harshul319/FSEV/ReadMe

These are the documents on the FSEV of IIT-KANPUR that I worked upon as the head of the powertrain subsystem and also the cad design (still under iterations) of a planetary gearbox thst we are gonna use in our next FSEV
