harshul319/FSEV/E13_IITKMotorsports_CRMR_2025_V1.pdf

Formula Bharat 2025 | Concept Resources Management Report (CRMR)
E 13 | IITK Motorsports | Indian Institute of Technology Kanpur

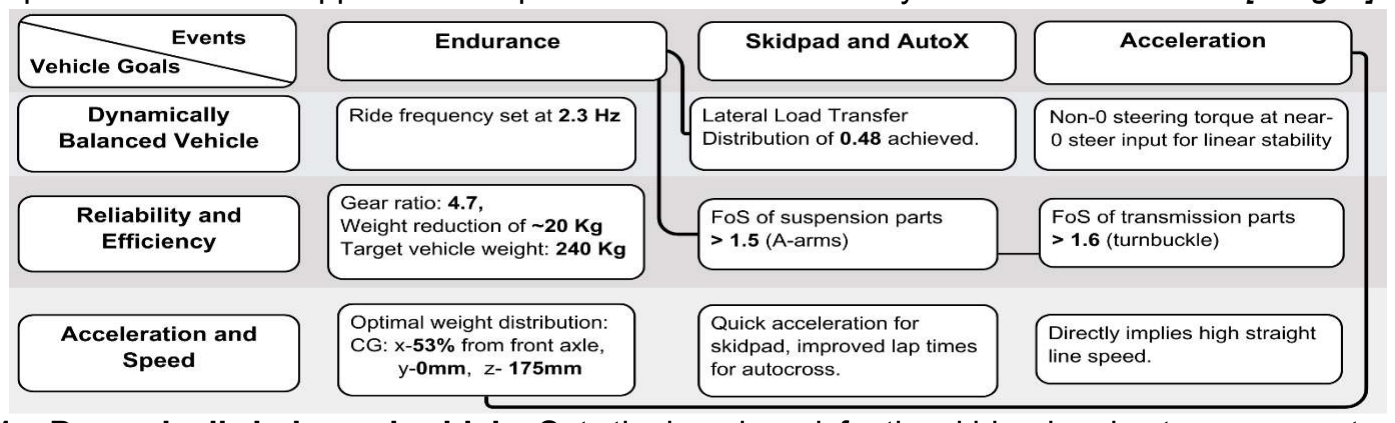
[picture p1: figure]
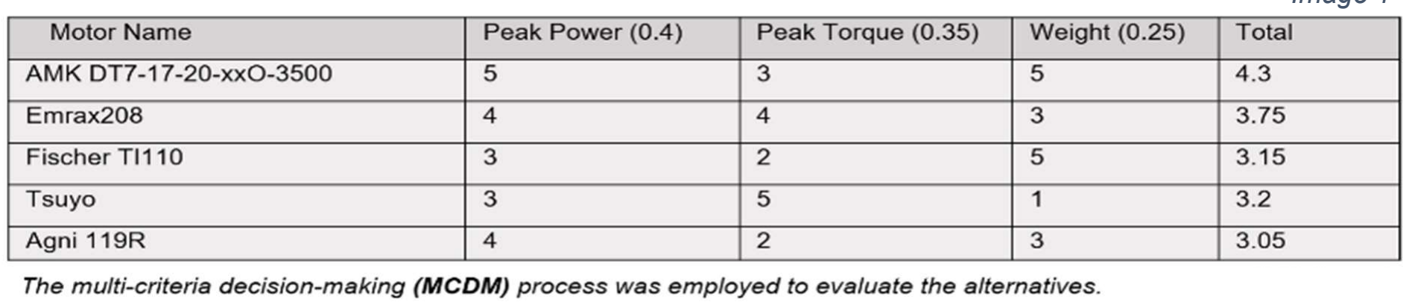
[picture p2: figure]

1 | 10

Formula Bharat 2025: Concept Resources Management Report

Through the CRM report, IITK Motorsports presents its unconstrained design ideology, efficient resource utilisation, and strategic project management for its second FSEV.
200+ minutes and 120+ km of testing of the team’s first FSEV, participation in FB24 and FB23 Class 1, and feedback from the judges have strengthened our engineering foundation. Our vision is to build the world's best FSEV while strategically navigating the constraints.
The section below outlines our vehicle goals and their importance in excelling as a team and at the dynamic events in a Formula Student competition.

Vehicle goals: The image below highlights the vehicle goals and the derived vehicle
specifications that support vehicle performance in different dynamic events. | [Image1]
1. Dynamically balanced vehicle: Sets the benchmark for the skidpad and autocross events.
- The best skidpad time in Formula Student is 4.43 seconds, achieved by the unconstrained parameters, our team achieved a simulated skidpad time of 4.60 seconds on OptimumLap software.
- The LLTD (image 2) of 0.48 was achieved for better cornering, with the ride frequency set to 2.3 Hz, matching a person's natural walking frequency.

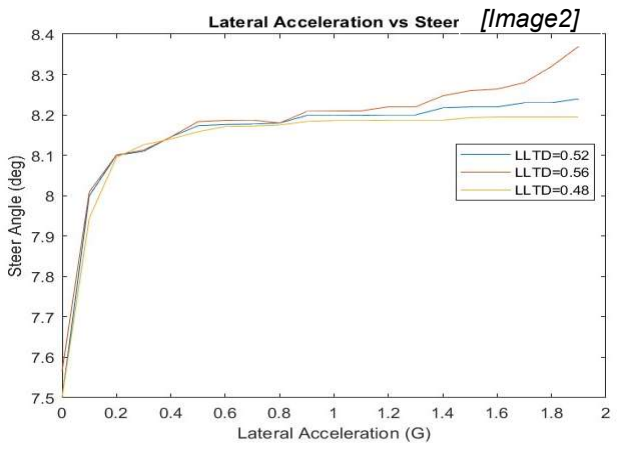
[picture p3: figure]
[Image2]

2. Acceleration and speed: This goal directly impacts the acceleration event.
- The best time for acceleration in Formula Student is 3.27 seconds. The team targeted a peak longitudinal acceleration of 8 m/s²
to achieve competitive times.
- Comparing various motors, disregarding constraints like cost, inverter availability, and experience, showed that the AMK DT7 meets our requirements best.
Image 1
- Simulated Acceleration time = 4.46 s; Peak longitudinal acceleration = 7.56 m/s² .

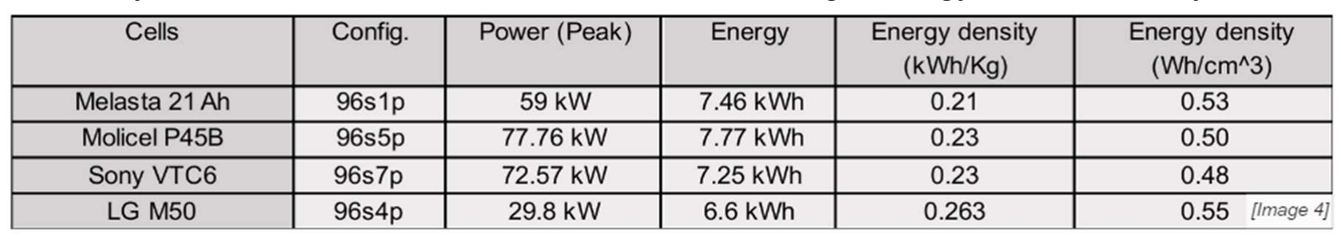
[picture p4: figure]
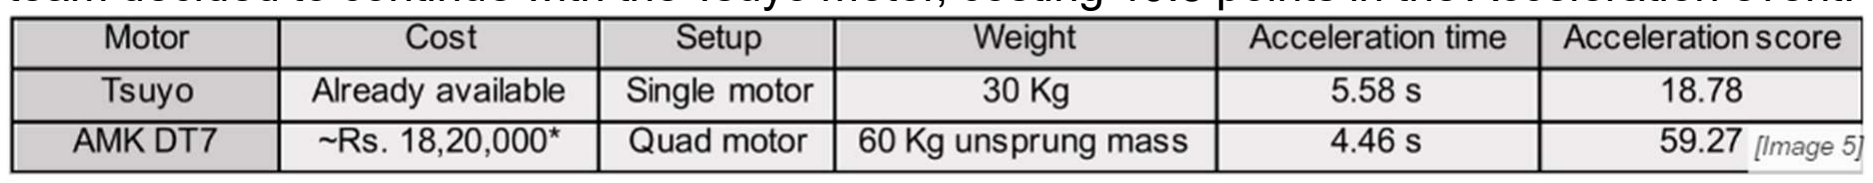
[picture p5: figure]
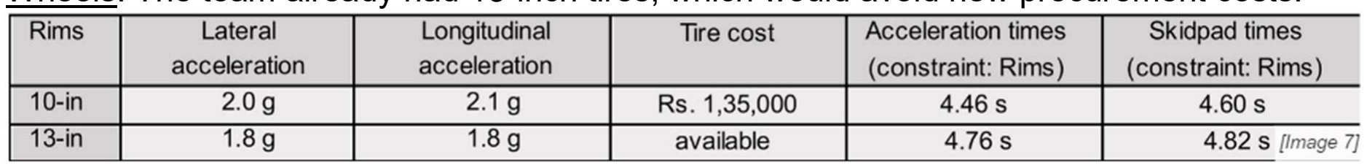
[picture p6: figure]
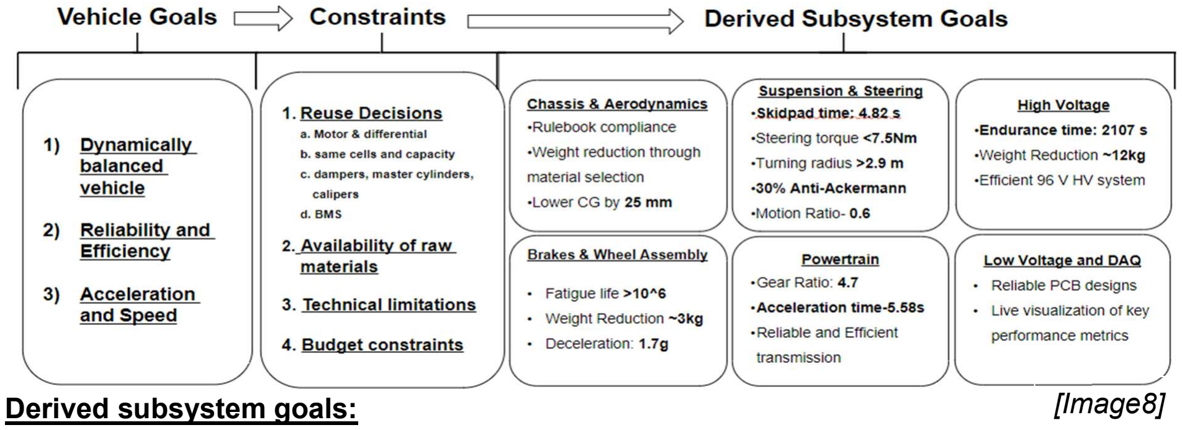
[picture p7: figure]
Derived subsystem goals:; [Image8]

2 | 10
3. Reliability and Efficiency: Aligns with the Endurance and Efficiency event objectives.
- Upon analysing endurance times, a target was set to complete the event in < 23.3 min.
- Recognising the high loads on suspension parts during skidpad and stress on transmission parts during acceleration, a FoS > 1.5 was set for critical components. After evaluating various options, Melasta cells were chosen since pouch cells simplify assembly, have UV-weldable tabs with busbars, and high energy volume density.

96S was chosen for easier segmentation and to meet the required energy storage and power output. Lap-time simulation results and parameters for unconstrained vehicle:
- Endurance Time: 1369 s - Required energy: 7.28 kWh, Battery capacity: 7.77 kWh
- Battery: Melasta 21Ah - Battery configuration: 96s1p
Constraints: The team views its constraints as an opportunity to turn limitations into strengths. Points or time losses were also assessed due to each constraint independently.
- Motor & Differential: Constrained by budget, but considering reliability and familiarity, the team decided to continue with the Tsuyo motor, costing 40.5 points in the Acceleration event.
- DNM Dampers, Brake Calipers & Master Cylinders were reused due to familiarity, although performance comparisons for alternatives were made.
- Wheels: The team already had 13-inch tires, which would avoid new procurement costs.
- Lack of availability of crucial raw materials such as Al 7075 blocks, AISI4130 tubes, high-end electrical components, UL-94-rated polycarbonate sheets, etc. around the college.
- Monocoque chassis could reduce the chassis weight from 32 kg to 23 kg but the shift is hindered due to lack of manufacturing resources, technical ineptitude, and budget issues.
A. Suspension and Steering: Setting parameters to achieve the simulated skidpad times.

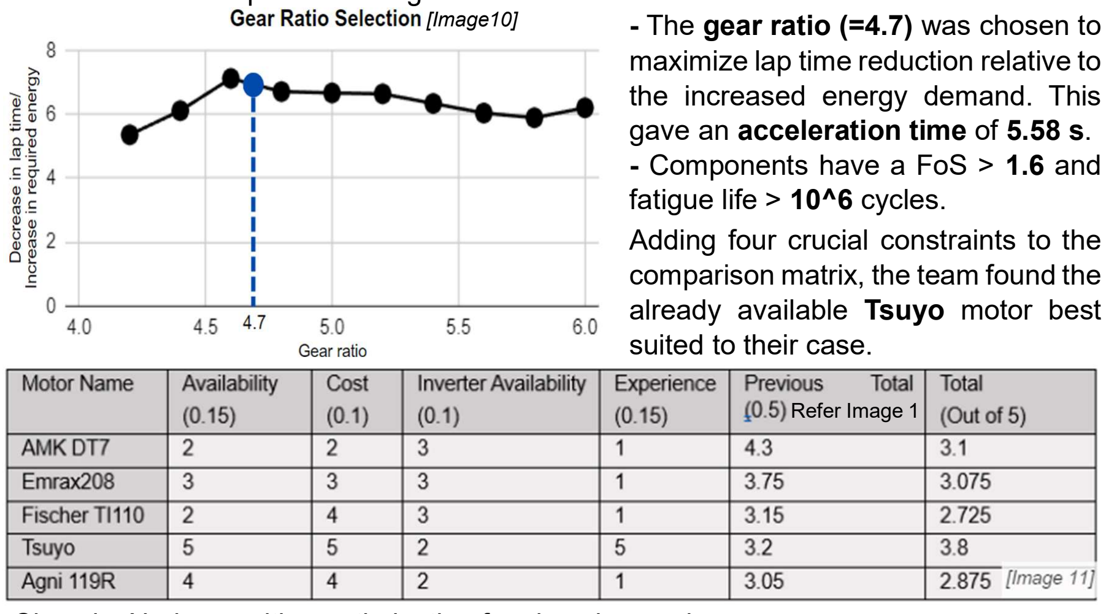
[picture p8: figure]
- The gear ratio (=4.7) was chosen to maximize lap time reduction relative to the increased energy demand. This gave an acceleration time of 5.58 s. - Components have a FoS > 1.6 and fatigue life > 10^6 cycles. Adding four crucial constraints to the comparison matrix, the team found the already available Tsuyo motor best suited to their case.; [Image10]; Refer Image 1
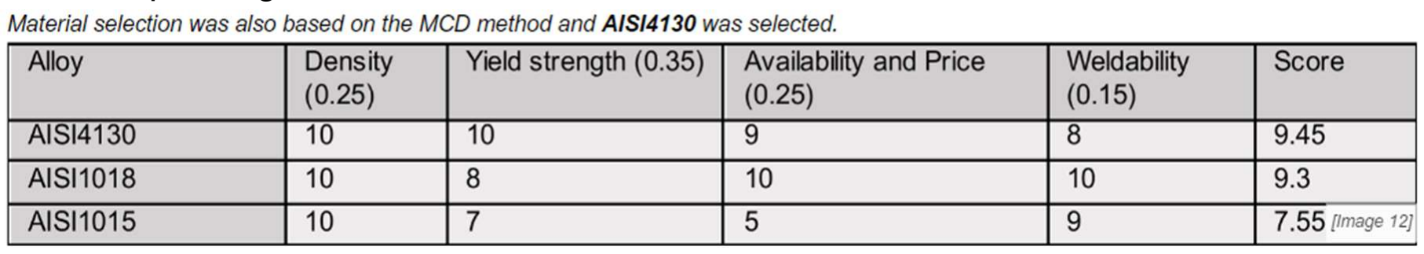
[picture p9: figure]

3 | 10

Retrospective Insights: Excess steering effort, higher CG, uneven tire wear due to camber loss while the minimum turning radius set and achieved on track was 3.7m and 4.5m.
- Utilizing TTC data to precisely calculate the steering torque and limit it to 7.5 Nm.
- Calculating optimal slip angles and setting a 30% anti-Ackermann geometry.
- Minimum turning radius is dynamically calculated and set to 2.9 m.
- The final LLTD value achieved was 0.44
- The caster angle is set to 3° to restrict camber loss and uneven tire wear.
The | team | effectively | managed the
constraint of using 13-inch rims, which

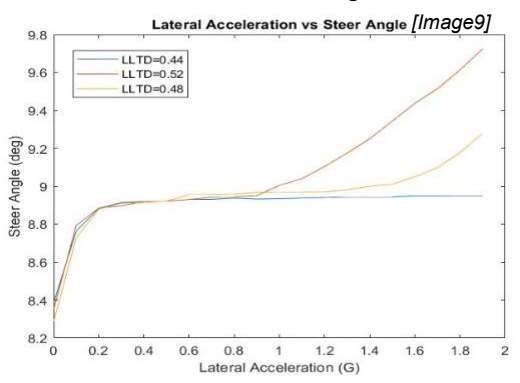
[picture p10: figure]
[Image9]

resulted in a minimal increase in skidpad time, from 4.60 seconds to 4.82 seconds.
B. Powertrain: Optimize gear ratio for endurance with balanced acceleration performance.
- Transmission components designed to withstand extreme loads.
C. Chassis: Nodes-position optimization for chassis members.
- Achieving higher torsional stiffness (3708 N/rad) and lowering CG height (by 25 mm)
- The spaceframe node positions are derived from a MATLAB model, selecting nodes corresponding to minimum deflection under identical load conditions.
D. Brakes and Wheel Assembly: Reduced weight and increased strength of components. Retrospective insights: Inaccurate dynamic load analysis led to the front hub failure.
- Weight target of knuckle, spindle and hub assembly = 2 kg.
- Using TTC data helped achieve a higher peak deceleration of 1.7g.
- Integrated hub and spindle design with FoS >1.5 and fatigue life >10⁶ cycles.
E. Aerodynamics: Increasing downforce for higher cornering speed and better handling.
- Limiting drag for better efficiency and greater speed on a straight track.

4 | 10
- Optimized Cl and Cd values to achieve a ratio of 2.5 (Cl: -2, Cd: 0.8).
- A downforce of 695 N was generated for an average vehicle velocity of 20 m/s.
F. High Voltage: Efficient thermal management and reduction in weight by 12 kg.
- BMS-controlled cooling ensures optimum fan speed for efficient cooling.
- The vehicle's endurance time was 2107 s (~35 min), requiring 3.59 kWh of energy.
- 24s2p configuration gives an 88.8 V nominal pack voltage, which lies in the controller range of 85-96 V, and 3.7 kWh capacity, and meets the energy requirements.
- Due to the success of last year's Orion BMS 2, we reused the same BMS.
G. Low voltage and Data Acquisition: Reliable PCB designs.
- SMD components on PCBs for noise reduction and optimal signal transmission.
- Over-current and reverse polarity protection and thermal rating for all custom PCBs.
- Open-circuit and short-circuit detection for all sensors used for Data Acquisition. Points Projection:
- Based on the lap times vs historical and projected best times, the team is positioned to secure 1st place in Endurance (325 pt), Efficiency (100 pt), and Skidpad (75 pt), 2nd in autocross (73.27 pt) and 3rd in Acceleration (18.78 pt), anticipating cumulative dynamic events score of over 592 pt.
- The team also targets over 290 pt in the static events, reflecting the historical averages of the winners.

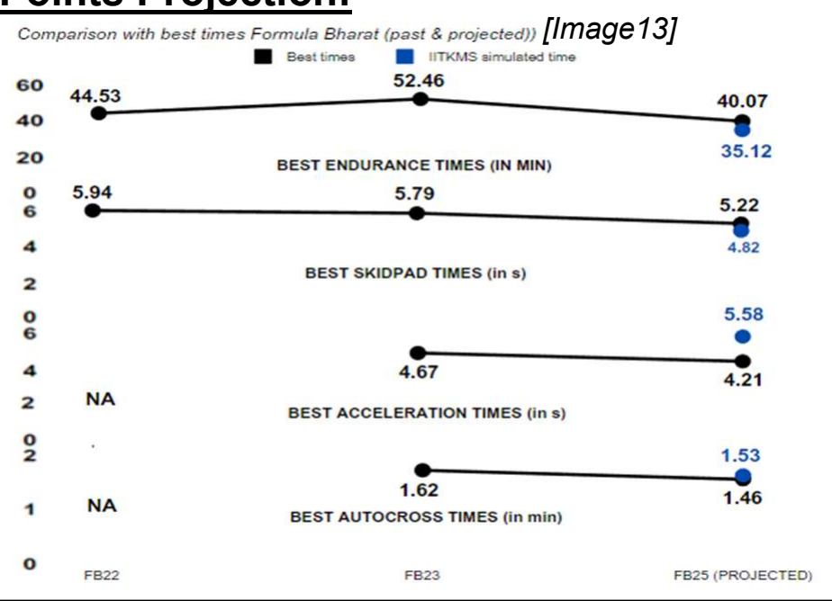
[picture p11: figure]
[Image13]

Our projected score is 882 out of 1000 points, positioning us to dominate the competition. Improvement areas:
The team seeks feedback to identify improvement areas and values external insights while prioritizing introspection. Committed to excellence, we refine strategies and turn limitations into innovative solutions, driving our pursuit of being the best. Key focus areas include:
1. 10-inch rims balance weight reduction with better handling for acceleration and cornering.
2. Lightweight, compact motors and AWD or 4WD systems for improved traction.
3. Regenerative braking converts braking energy into usable power, enhancing efficiency.
4. Anti-roll bar linkage reduces vehicle roll during cornering, allowing for softer spring rates.
5. Liquid cooling stabilizes accumulator temperature and handles extreme conditions better.
6. Undertaking of the development of BMS by the electrical subsystems.
7. Electronics feature negative feedback and voltage detection for precharge circuits, CAN communication for display, and a Vehicle Control Unit for vehicle monitoring.
Tools:

### 1. Computational and Analytical Tools:

a. Ansys: FEA simulations of components including static analysis and topology optimization of components to obtain deformation, FoS, stress, and strain values.
b. Ansys Fluent: Cooling analysis of battery pack, CFD analysis of airfoils.
c. SolidWorks: Design of individual parts along with assembly of the complete vehicle, also used as a tool to validate FEA values from Ansys
d. Altium: Primary tool for the design and simulation of circuit designs.
e. Orion CAN software: To configure BMS for the motor controller and charger, and assess battery parameters like temperature and SoC.
f. Tsuyo Live software for motor tuning and motor controller configuration.
The team has extensively used modeling and simulation tools like MATLAB, Lotus Shark, and OptimumLap. The Simulations and models are listed in the image.

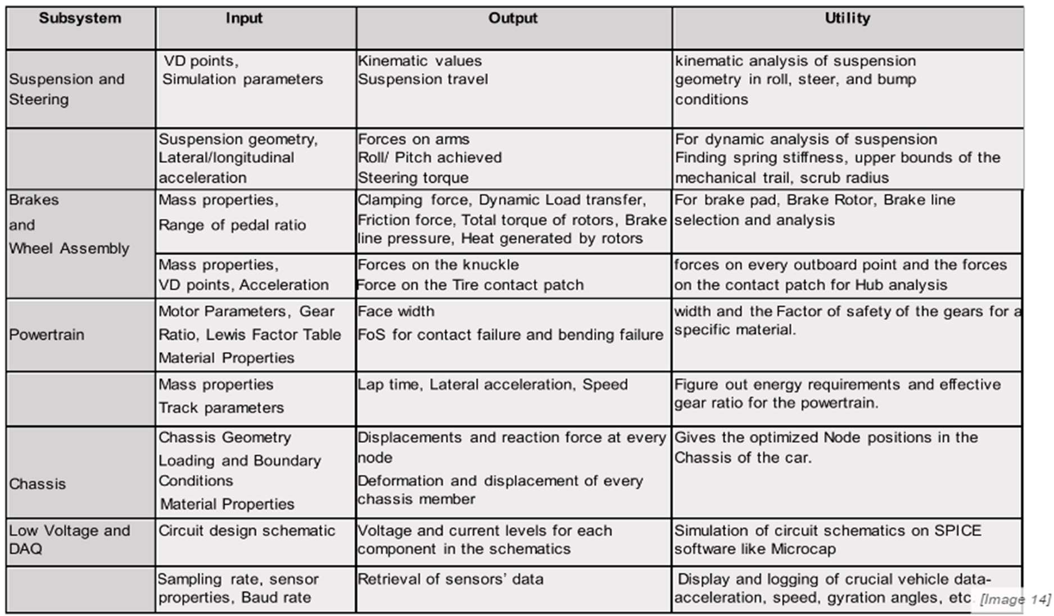
[picture p12: figure]
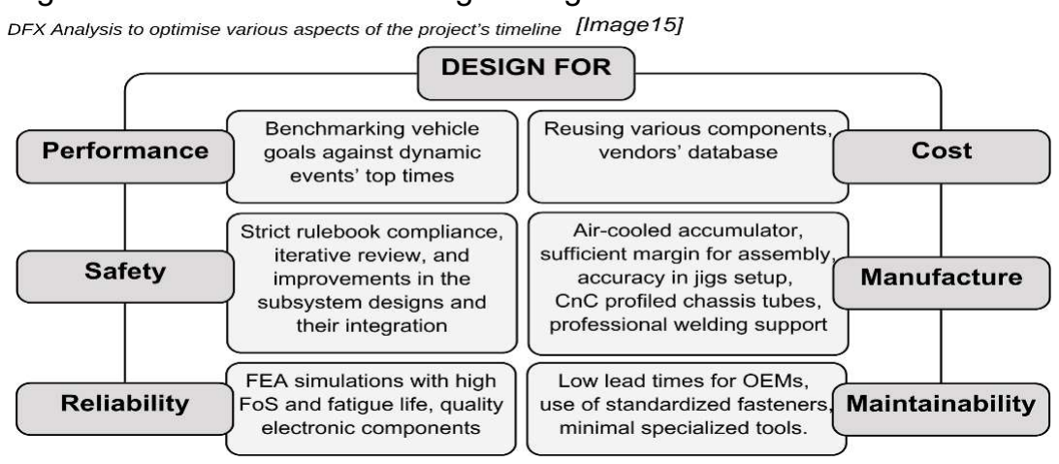
[picture p13: figure]

5 | 10

### 2. Experimental Validation:

a. Individual components: The components are validated through testing in the institute labs, including chassis tube testing, electronic circuits testing on the breadboard, cell performance to assure reliable power delivery, and damper testing.
b. Prototype models: Certain prototype models like PVC tubes chassis, 3D printed sprockets and wooden frames for the accumulator are built to check for compliances.
c. Integrated component testing involves checking the accumulator for reliable power delivery, connecting the motor with the accumulator, and testing the brakes.
d. Testing the complete vehicle: Comprehensive post-integration testing and data analysis using DAQ systems will evaluate vehicle performance, ensuring competitive readiness and securing points.

### 3. Design process management:

The team uses Bitrix24, to oversee all aspects of team operations, including design, manufacturing, and general tasks. The software's key features are:
a. Utilizing the Workgroups section, we strategize task allocation, schedule meetings, and formulate subsystem-specific Gantt charts for timeline management.
b. The software's flexible planning chart pattern aids in seamless deadline management.
c. Google Drive is used for file management, designating spaces for each subsystem, ensuring smooth file and data sharing among team members.

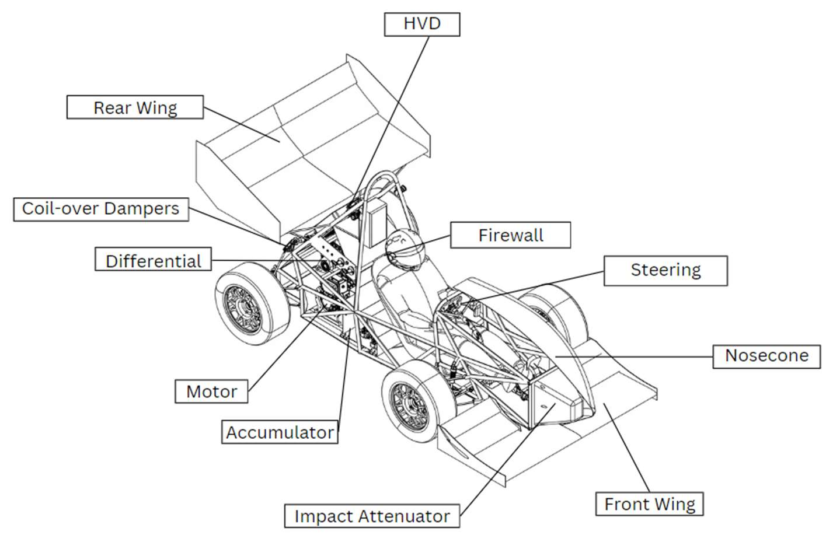
[picture p14: figure]
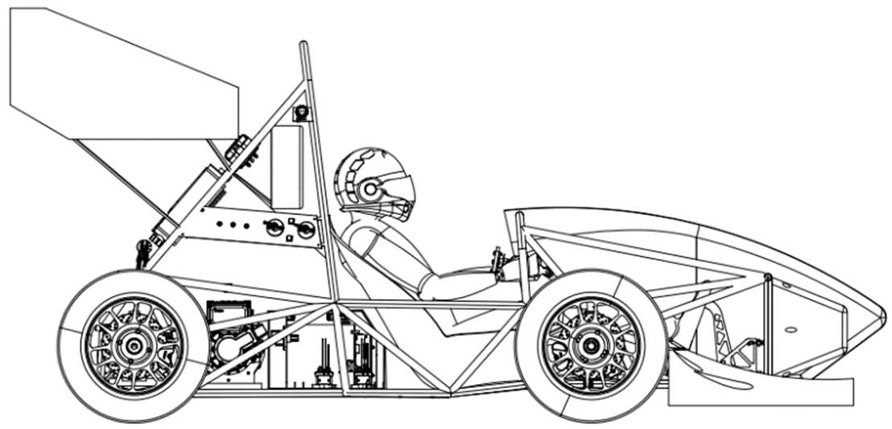
[picture p15: figure]

6 | 10
Car parameter | Specification
Top Speed (on track) | 100 km/h
Maximum Acceleration/Deceleration | 6.36 m/s² / 1.7g
Motor Torque/Power | 140 Nm/ 30 kW
Vehicle weight | 220 Kg
Battery voltage | 96 V (Air-cooled)
Battery capacity | 3.7 kWh
Battery Configuration | 24s2p in 3 segments
Transmission | Chain and sprocket (final drive ratio = 4.7)

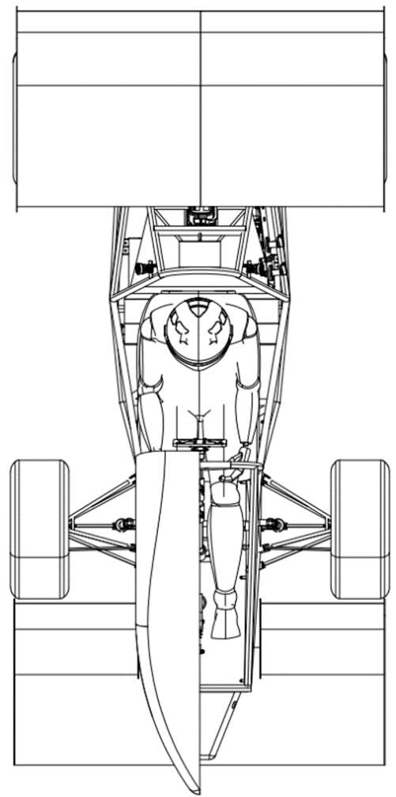
[picture p16: figure]
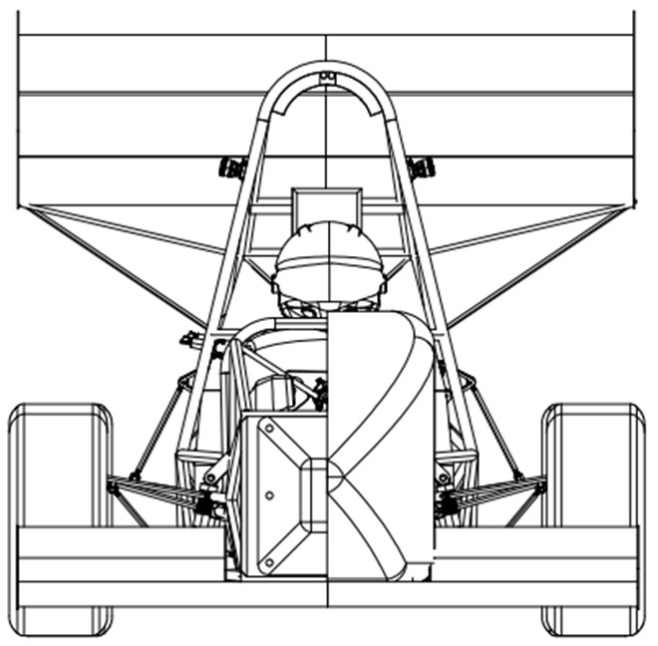
[picture p17: figure]

Our design journey began with an unconstrained vision, evolving into a real vehicle defined by optimal use of constraints. In the management section, we’ll explore efficient resource utilization and seamless coordination to ensure the success of our Formula Student Electric Vehicle project.

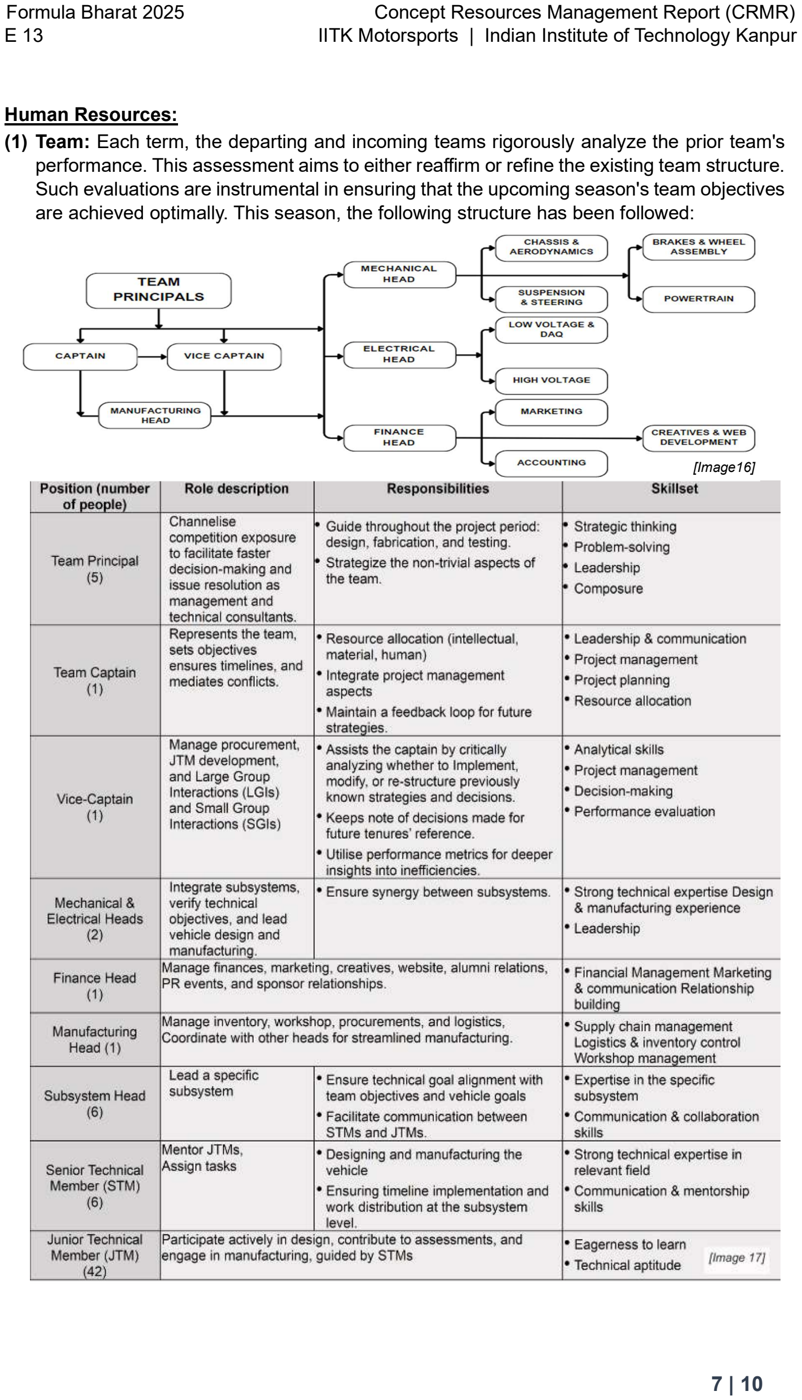
[picture p18: page 7]

7 | 10

Human Resources:
(1) Team: Each term, the departing and incoming teams rigorously analyze the prior team's performance. This assessment aims to either reaffirm or refine the existing team structure. Such evaluations are instrumental in ensuring that the upcoming season's team objectives are achieved optimally. This season, the following structure has been followed:

[Image16]

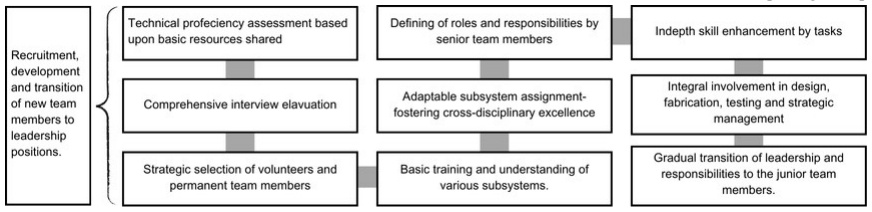
[picture p19: figure]
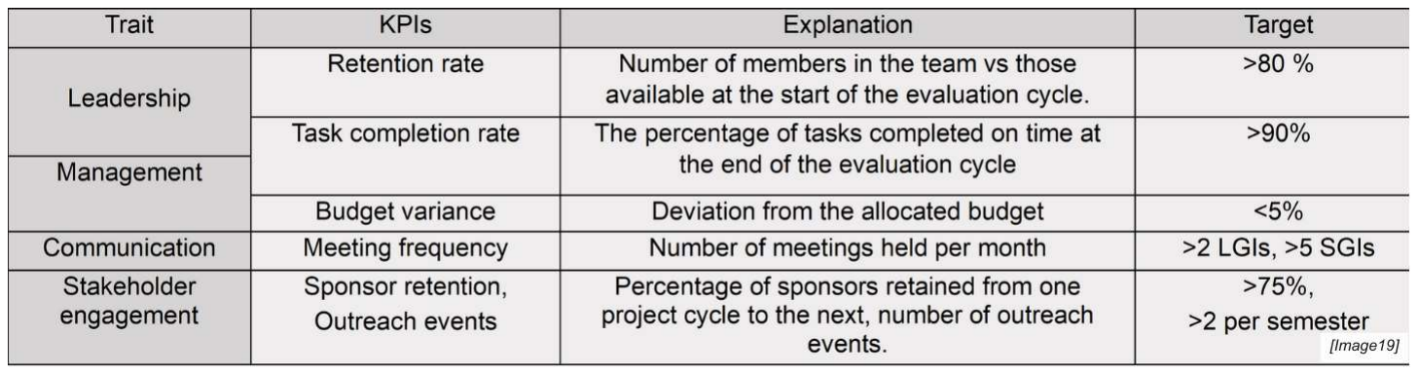
[picture p20: figure]
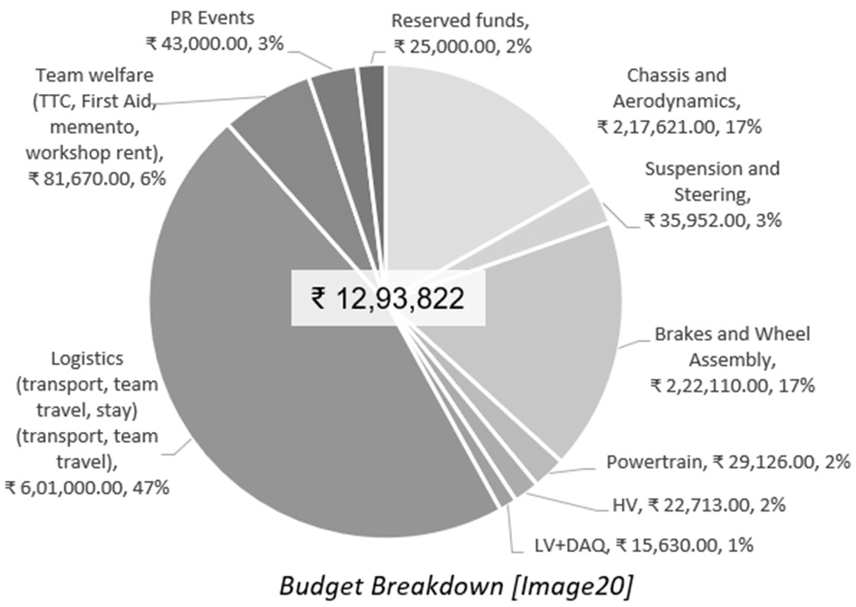
[picture p21: figure]

8 | 10

To keep the sub-team responsible for the Team Project Management in check and define parameters for excellence in management, we have set in place performance metrics and evaluation methods.

These metrics are calculated through general but effective evaluation methods:
a. All-round feedback: Taking quarterly feedback based on uniformly scaled metrics from team members, faculty advisors, sponsors, and administration through forms.
b. Objective measurements: Maintaining progress reports, and budget reports and tracking the timeline gives direct insight into the defined KPIs.

### 2. Partners: The marketing and finance team, alongside the technical team, identifies

potential partners, including MNCs, educational institutions, and OEM vendors, to secure funding and vital parts. Alumni and staff also contribute their experience and knowledge. The team has also retained sponsors from the last season with a retention rate of 72.2%. ●Sustaining of partners: Establish partnerships through MOUs and sponsorship contracts, defining mutual benefits and risk mitigation. Maintain open communication and provide regular updates through monthly progress reports and quarterly meetings.
●Events and Activities: The team strategically organizes events year-round to maintain a strong presence and actively engage with the campus community and partners.

Financial Resources Management
The team's financial goals involve
strategic planning, allocation, and
utilization of funds to meet yearly objectives. The total budget for the
season | 2024-25, | covering
components, | manufacturing,
competition, and operational costs is approximately INR 12.94 lakhs with a ~2% flexibility margin. The pie chart shows the subsystem-wise budget breakdown.

[Image 18]

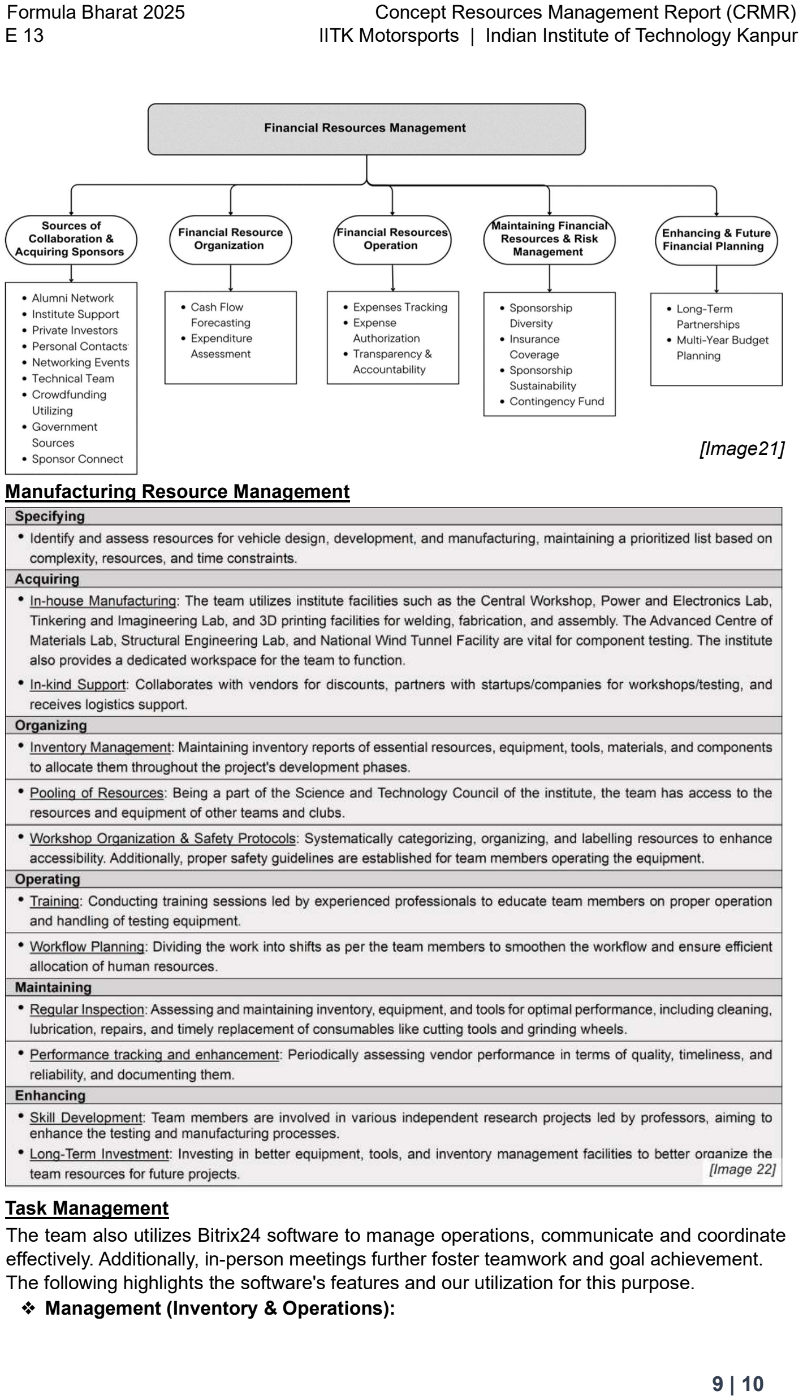
[picture p22: page 9]

9 | 10

Manufacturing Resource Management

Task Management
The team also utilizes Bitrix24 software to manage operations, communicate and coordinate effectively. Additionally, in-person meetings further foster teamwork and goal achievement. The following highlights the software's features and our utilization for this purpose.
❖ Management (Inventory & Operations):

[Image21]

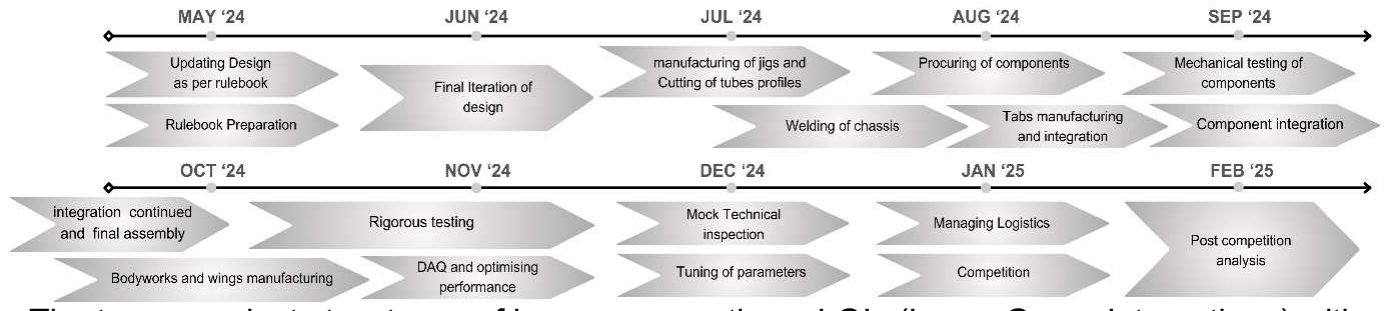
[picture p23: figure]
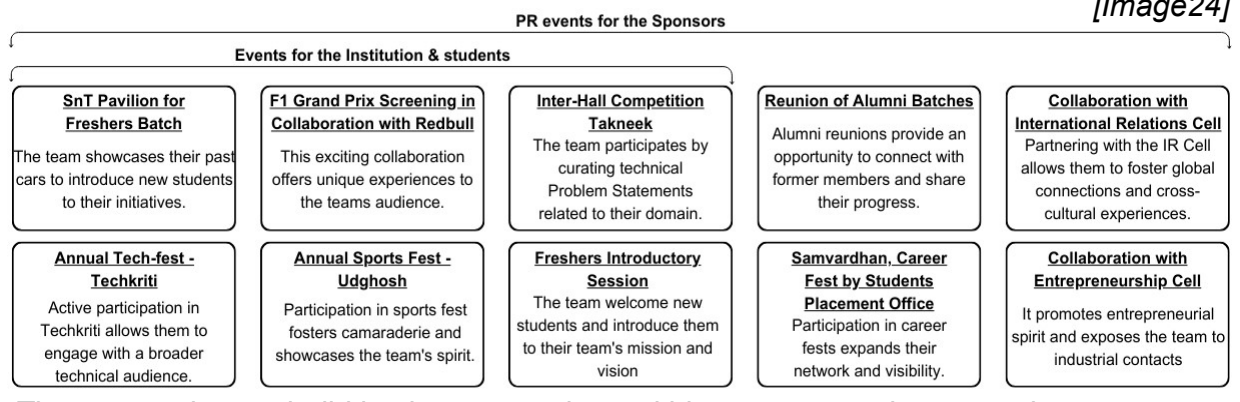
[picture p24: figure]

10 | 10
- Vendor and Company Logs: Maintain records of organizational contacts and procurement specifics in the Inventory Management tab.
- Inventory Oversight: Oversee inventory and log all accessible hardware resources. ❖ Communication:
- Chat and Call Features: Streamline information exchange and direct communication within the team, minimizing misunderstandings.
- Dynamic POCs: Maintain Points of Contact for subsystem tasks in the Company tab, ensuring coverage if a member is unavailable.
- Feed Tab: Provide general updates, including meeting minutes and work progress. ❖ Coordination:
- Event Calendar: Monitor important deadlines and submission dates.
- Mobile Accessibility: Manage projects and communicate on-the-go.
- CRM Integration: Access Instagram, Facebook, and LinkedIn pages to track communications and requests from vendors and sponsors.

The team conducts two types of in-person meetings: LGIs (Large Group Interactions) with the full team and inter-subsystem meetings, and SGIs (Small Group Interactions) within the subsystem. LGIs follow protocols, while SGIs are more frequent and harder to manage.
- Pre-Meeting Agenda: A clear pre-meeting agenda is released before each meeting.
- Rotation of SGI Facilitators: Different people take turns leading small group meetings.
- 360° Feedback: Everyone's feedback is actively sought and considered.
- Minutes of Meeting: Detailed meeting minutes are maintained to keep track of discussions and decisions this ensures that everyone is up to date.

The team strives to build lasting connections within our community, promoting collaboration, knowledge sharing, and mutual support. These events serve as a bridge that unites our stakeholders and enhances the team's overall mission.

In Conclusion: At the core, all team members of IITK Motorsports are driven by the dedication to build a top-notch team and vehicle and represent their institution globally. Our shared goals, transparent updates, defined roles, and inclusive culture strengthen our unity. As rightly implied by Claude Rouelle, making an A team and a C car is vital, trying to make an A car with a C team will lead to pointing fingers and destroy the team's morale.

[Image23]

[Image24]
