harshul319/FSEV/Planetary/step.STEP

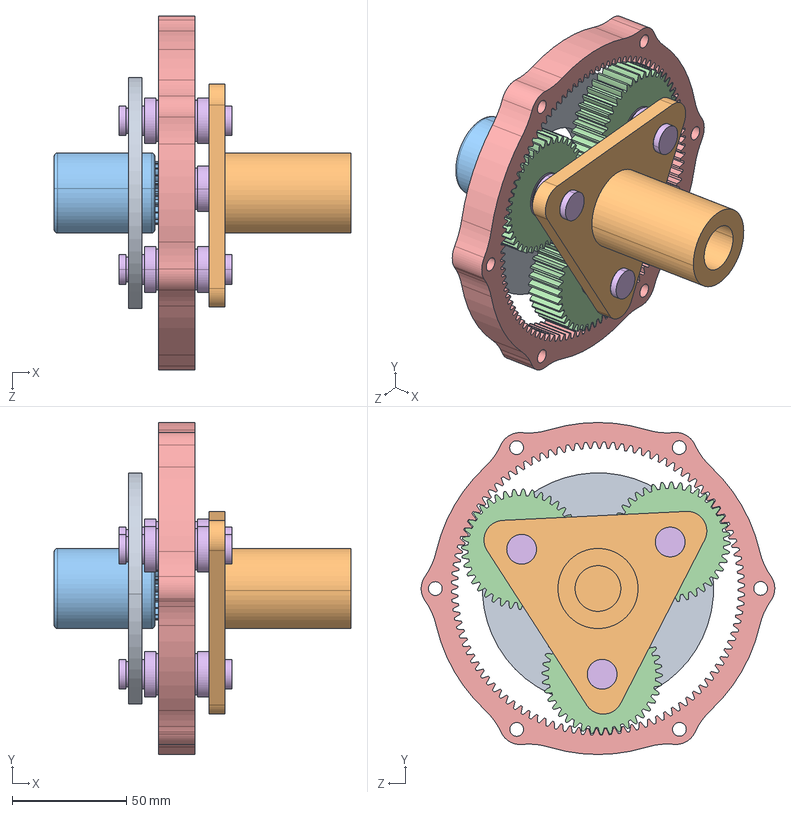
[picture p65: CAD file, 2025-07-06]
Planetary/step.STEP
129.6 x 145.0 x 154.5 mm
ICarrier3
OCarrier3
SUN3
PLANET3 x 3
RING3
PlanetShaft3 - Copy x 3
